na-ka-no/am312_config/hardware/pir_switch_main/pir_switch_main_schematic.pdf

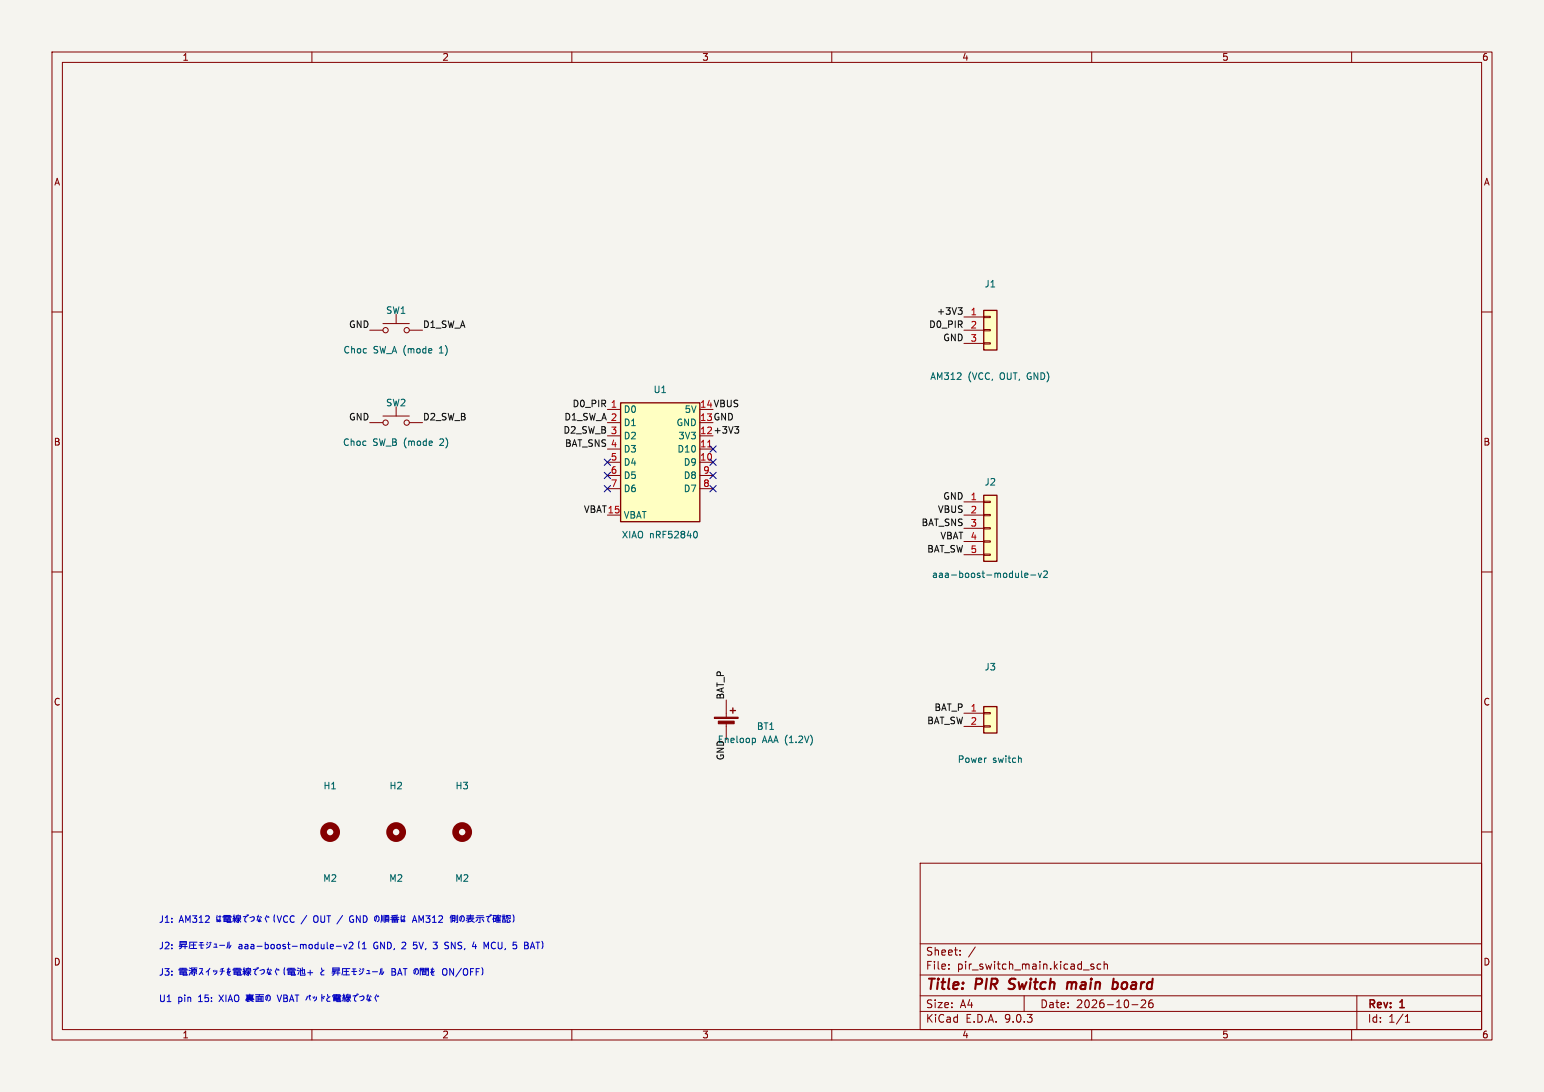
[picture p3: page 1]

J1: AM312 þÿ0o–û}Ú0g0d0j0PÿVCC / OUT / GND þÿ0n˜uj0oAM312 þÿPt0nˆhy:0gxºŠ•ÿ J2: þÿfW'0â0¸0å0ü0ë þÿaaa-boost-module-v2ÿ1 GND, 2 5V, 3 SNS, 4 MCU, 5 þÿBATÿ J3: þÿ–ûn•0¹0¤0Ã0Á0’–û}Ú0g0d0j0Pÿ–ûl`+ þÿ0hþÿfW'0â0¸0å0ü0ë BAT þÿ0n•“0’þÿON/OFFÿ

Id: 1/1 Title: PIR Switch main board
