na-ka-no/am312_config/hardware/pir_switch_main/pir_switch_main.kicad_pcb

## KiCad design hardware/pir_switch_main/pir_switch_main.kicad_pcb (2026-10-26)

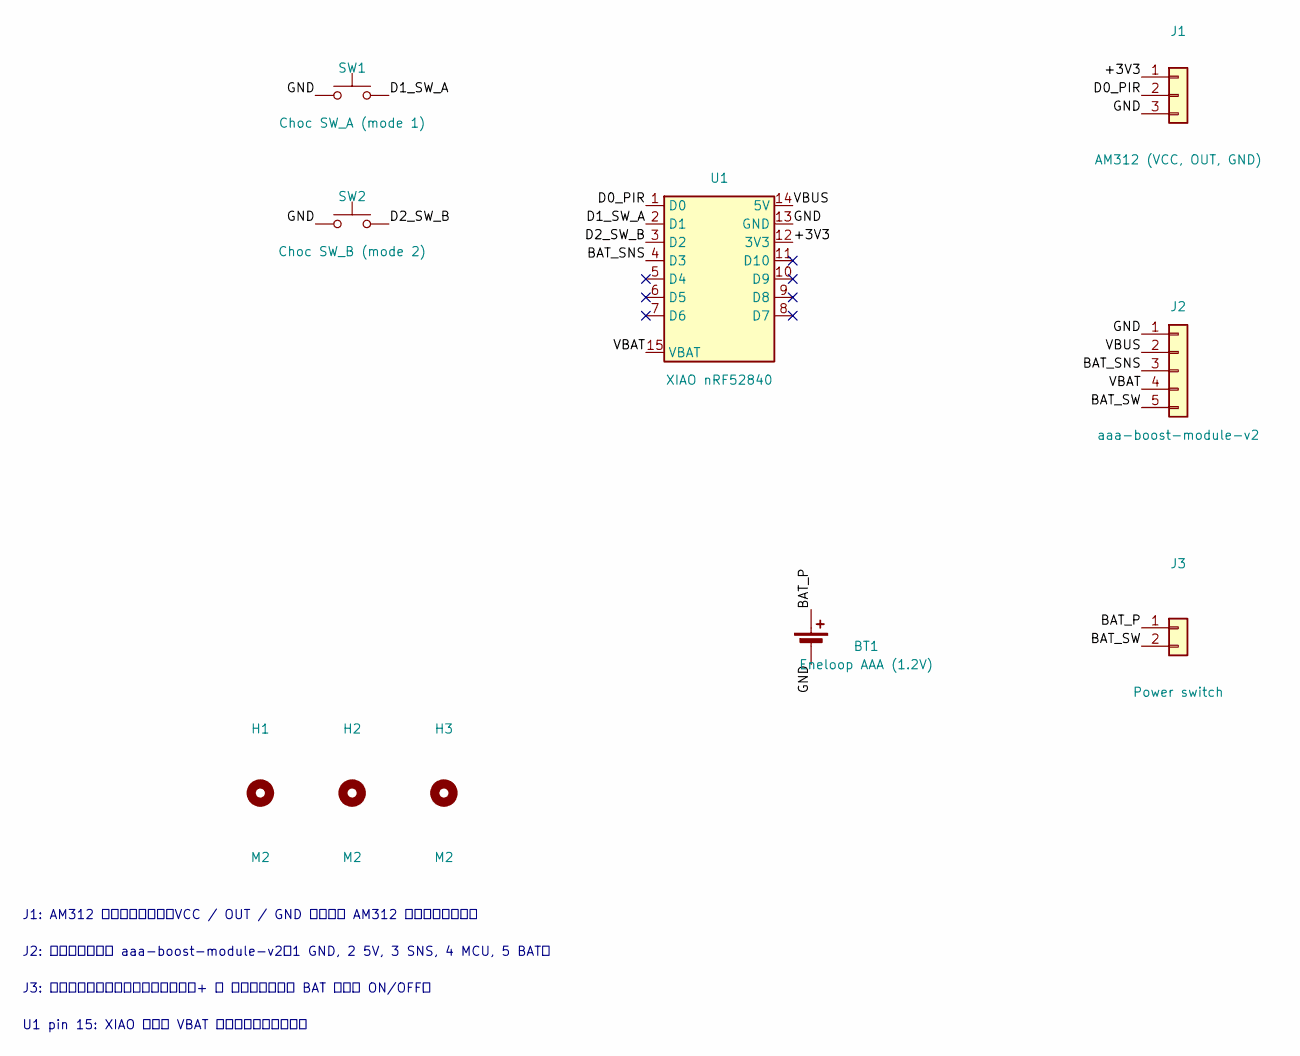
[picture p4: schematic pir_switch_main.kicad_sch, PIR Switch main board]

Parts:
BT1: Eneloop AAA (1.2V); BatteryHolder_Keystone_2466_1xAAA
H1, H2, H3: M2; MountingHole_2.2mm_M2
J1: AM312 (VCC, OUT, GND); PinHeader_1x03_P2.54mm_Vertical
J2: aaa-boost-module-v2; Header_1x05_P2.54mm_Compact
J3: Power switch; PinHeader_1x02_P2.54mm_Vertical
SW1: Choc SW_A (mode 1); Kailh_Choc_V1
SW2: Choc SW_B (mode 2); Kailh_Choc_V1
U1: XIAO nRF52840; XIAO_nRF52840_THT_VBAT

Connections:
/+3V3: J1.1, U1.12 (3V3)
/BAT_P: BT1.1 (+), J3.1
/BAT_SNS: J2.3, U1.4 (D3)
/BAT_SW: J2.5, J3.2
/D0_PIR: J1.2, U1.1 (D0)
/D1_SW_A: SW1.2, U1.2 (D1)
/D2_SW_B: SW2.2, U1.3 (D2)
/GND: BT1.2 (-), J1.3, J2.1, SW1.1, SW2.1, U1.13 (GND)
/VBAT: J2.4, U1.15 (VBAT)
/VBUS: J2.2, U1.14 (5V)

Notes on the sheet:
J1: AM312 は電線でつなぐ（VCC / OUT / GND の順番は AM312 側の表示で確認）
J2: 昇圧モジュール aaa-boost-module-v2（1 GND, 2 5V, 3 SNS, 4 MCU, 5 BAT）
J3: 電源スイッチを電線でつなぐ（電池+ と 昇圧モジュール BAT の間を ON/OFF）
U1 pin 15: XIAO 裏面の VBAT パッドと電線でつなぐ

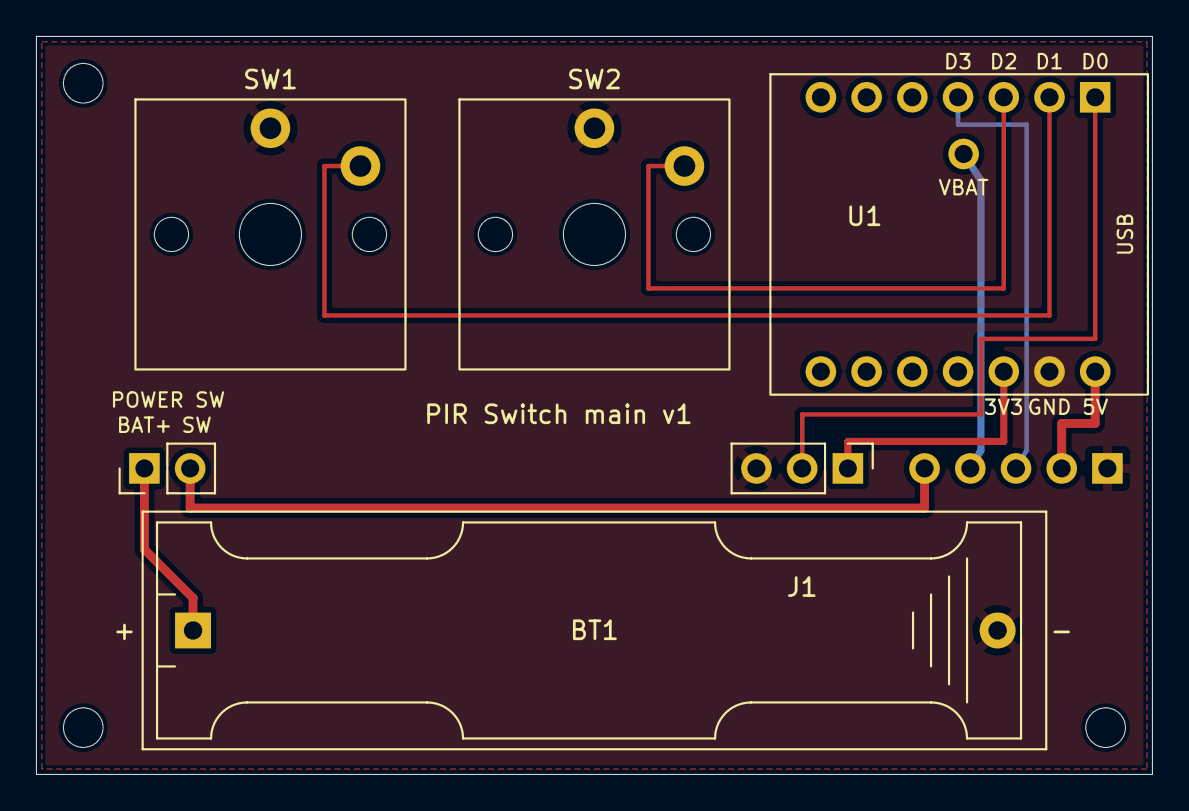
[picture p5: board pir_switch_main.kicad_pcb from above]

Board: 2 copper layers, 62.0 x 41.0 mm, 10 parts (0 on the bottom side), 10 nets.
