na-ka-no/am312_config/(commit log)

2026-10-21 Rename Kconfig.shield to config/boards/shields /Kconfig.shield
2026-10-21 Update board name in build.yaml for compatibility
2026-10-22 Fix shield layout and pin ZMK to v0.3.0
    - Move shield files into config/boards/shields/pir_switch/
    - Rename pir_switchKconfig.defconfig to Kconfig.defconfig
    - Pin west.yml to v0.3.0 to match the workflow version
    - Use seeeduino_xiao_ble board name for v0.3.0
2026-10-22 Switch ZMK to main branch (Zephyr 4.x)
2026-10-23 Light the green LED until the sensor can trigger again
    Turn on status-led when the sensor fires and turn it off
    status-led-hold-ms (2s, the AM312 blocking time) after the output
    returns LOW.
2026-10-25 Add mode switches, external LEDs, and persisted state
    - Replace the config macro with zmk,behavior-pir-switch (&pir CMD)
    - Two switches on D1/D2: tap runs a test, 3s hold selects mode 1/2
    - Both switches: tap toggles the LED indicator, 3s hold clears bonds
    - External green/blue LEDs on D3/D4 show the current mode
    - Persist mode and LED on/off in settings
    - Config format v2 holds one key sequence per mode; rebuild the
    settings page with a tab per mode
    [behavior_pir_switch.c]
2026-10-25 Drive mode LEDs with SK6812MINI-E under the switches
    Replace the two GPIO LEDs with a two-pixel WS2812-compatible chain on
    SPI3 MOSI (D5). The LED under switch A shows mode 1 in green and the
    LED under switch B shows mode 2 in blue. D3 and D4 are now free.
    [behavior_pir_switch.c]
2026-10-25 Report Eneloop battery level from the boost module SNS pin
    - Add zmk,battery-nimh-voltage-divider: reads SNS (Vbat x 470k/1.47M)
    on D3/AIN5 and maps NiMH voltage (1.0-1.35V) to percent
    - Use it as zmk,battery and disable the board vbatt, which only sees
    the boosted BAT+ voltage
    - Enable ZMK battery reporting so the level shows over BLE
2026-10-25 Use the XIAO onboard LED instead of SK6812MINI-E
    Drive the onboard green (led1) and blue (led2) LEDs over GPIO for the
    mode indicator. Drop the SPI LED strip and the I2C disable, freeing
    D4/D5.
2026-10-25 Show battery level on the onboard LED at power-on
    One second after boot, read the battery sensor value ZMK just sampled
    and light the LED for 2s: green >= 50%, yellow 20-49%, red < 20%.
    Skip it when no battery is connected (< 0.9V on SNS).
    [behavior_pir_switch.c]
2026-10-26 Add KiCad main board for PIR Switch
    62 x 41 mm two-layer board carrying the XIAO nRF52840 on pin headers,
    two Kailh Choc V1 switches, a Keystone 2466 AAA holder, and headers for
    the AM312, the aaa-boost-module-v2, and an external power switch.
    Includes a hole under the XIAO VBAT pad for a wire. ERC, DRC and
    schematic parity all report zero issues on KiCad 9.0.3.
    [bom.csv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]
2026-11-08 Ignore 3D case data
